timex-sinclair-projects/openspand-smd/card/docs/card-render-back.png

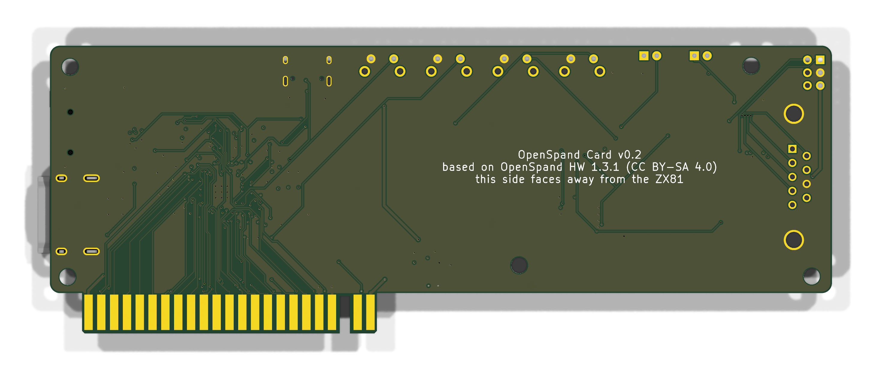
card/docs/card-render-back.png
