timex-sinclair-projects/openspand-smd/card/hardware/fab/BOM-JLCPCB.csv

Comment | Designator | Footprint | LCSC Part #
CR2032 | BT1 | BatteryHolder_Keystone_3034_1x20mm | C5213768
22u | C1 | C_0805_2012Metric | C45783
100n | C10,C11,C12,C13,C14,C15,C16,C17,C18,C19,C20,C24,C25,C26,C29,C30,C31,C33,C32,C34,C45 | C_0603_1608Metric | C14663
10u | C2,C3,C4,C35 | C_0805_2012Metric | C15850
4.7u | C22,C23,C21 | C_0603_1608Metric | C19666
15p | C27,C28 | C_0603_1608Metric | C1644
1u | C5,C46 | C_0603_1608Metric | C15849
B5819W | D1,D2,D5 | D_SOD-123 | C8598
USB-C | J3 | USB_C_Receptacle_HRO_TYPE-C-31-M-12 | C165948
microSD | J5 | TF-01A | C91145
HDMI | J8 | HDMI_A_Molex_208658-1001_Horizontal | C916313
33 | R1 | R_0603_1608Metric | C23140
1k | R2,R4 | R_0603_1608Metric | C21190
2.2k | R22,R23 | R_0603_1608Metric | C4190
220 | R24,R25,R26,R27,R28,R29,R30,R31 | R_0402_1005Metric | C25091
10k | R3,R11,R12,R13,R14,R15 | R_0603_1608Metric | C25804
5.1k | R5,R6 | R_0603_1608Metric | C23186
27 | R7,R8 | R_0603_1608Metric | C25190
4.7k | R9,R10 | R_0603_1608Metric | C23162
ME6211C33M5G | U1 | SOT-23-5 | C82942
TPD4E05U06DQAR | U10,U11 | USON-10_2.5x1.0mm_P0.5mm | C138714
RP2350B | U2 | QFN-80-1EP_10x10mm_P0.4mm_EP3.4x3.4mm | C42415655
W25Q128JVSIQ | U3 | SOIC-8_5.3x5.3mm_P1.27mm | C97521
MCP23009-E/SS | U4 | SSOP-20_5.3x7.2mm_P0.65mm | C629436
DS3231MZ+TRL | U5 | SOIC-8_3.9x4.9mm_P1.27mm | C107410
FT24C32A | U6 | SOIC-8_3.9x4.9mm_P1.27mm | C232883
SN74LVC3G34DCUR | U8 | VSSOP-8_2.3x2mm_P0.5mm | C130024
ME6211C12M5G-N | U9 | SOT-23-5 | C236672
12MHz | Y1 | Crystal_SMD_3225-4Pin_3.2x2.5mm | C20625731
