timex-sinclair-projects/openspand-smd/card/hardware/fab/hand-solder.csv

Designator | Value | Footprint | Note
SW1 | Reset | SW_Tactile_SPST_Angled_PTS645Vx83-2LFS | right-angle THT button on the top edge, hand-soldered
SW2 | RUN | SW_Tactile_SPST_Angled_PTS645Vx83-2LFS | right-angle THT button on the top edge, hand-soldered
SW3 | BOOTSEL | SW_Tactile_SPST_Angled_PTS645Vx83-2LFS | right-angle THT button on the top edge, hand-soldered
SW4 | Config | SW_Tactile_SPST_Angled_PTS645Vx83-2LFS | right-angle THT button on the top edge, hand-soldered
J4 | Joystick | DSUB-9_Male_Horizontal_P2.77x2.84mm_EdgePinOffset4.94mm_Housed_MountingHolesOffset7.48mm | Atari-style joystick, hand-soldered THT
J6 | External SPI | PinHeader_2x03_P2.54mm_Vertical
D3 | Red | LED_D3.0mm_Horizontal_O1.27mm_Z2.0mm | 3 mm red diffused, legs bent 90 deg, looks out of the top edge; driven by the I/O expander (GP2, open drain, active low); hand-soldered THT
D4 | Green | LED_D3.0mm_Horizontal_O1.27mm_Z2.0mm | 3 mm green diffused, legs bent 90 deg, looks out of the top edge; hand-soldered THT
