timex-sinclair-projects/openspand-smd/card/hardware/OpenSpand-Card.kicad_pcb

## KiCad design card/hardware/OpenSpand-Card.kicad_pcb (2026-11-07)

Schematic: OpenSpand-Card.kicad_sch, OpenSpand Card

Parts:
BT1: CR2032; BatteryHolder_Keystone_3034_1x20mm; MPN Keystone 3034TR; LCSC C5213768
C1: 22u; C_0805_2012Metric; LCSC C45783
C2, C3, C4, C35: 10u; C_0805_2012Metric; LCSC C15850
C5, C46: 1u; C_0603_1608Metric; LCSC C15849
C10, C11, C12, C13, C14, C15, C16, C17, C18, C19, C20, C24, C25, C26, C29, C30, C31, C32, C33, C34, C45: 100n; C_0603_1608Metric; LCSC C14663
C21, C22, C23: 4.7u; C_0603_1608Metric; LCSC C19666
C27, C28: 15p; C_0603_1608Metric; LCSC C1644
D1, D2, D5: B5819W; D_SOD-123; LCSC C8598
D3: Red; LED_D3.0mm_Horizontal_O1.27mm_Z2.0mm; MPN Kingbright WP710A10ID; not fitted
D4: Green; LED_D3.0mm_Horizontal_O1.27mm_Z2.0mm; MPN Kingbright WP710A10GD; not fitted
H1, H2, H3, H4, H5: M3; MountingHole_3.2mm_M3
J1: ZX81 edge; ZX81_EdgeFingers
J3: USB-C; USB_C_Receptacle_HRO_TYPE-C-31-M-12; LCSC C165948
J4: Joystick; DSUB-9_Male_Horizontal_P2.77x2.84mm_EdgePinOffset4.94mm_Hou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
J5: microSD; TF-01A; LCSC C91145
J6: External SPI; PinHeader_2x03_P2.54mm_Vertical; not fitted
J8: HDMI; HDMI_A_Molex_208658-1001_Horizontal; MPN Molex 2086581001; LCSC C916313
JP1: 5V pin 7; SolderJumper-2_P1.3mm_Open_RoundedPad1.0x1.5mm
JP2: 5V pin 5; SolderJumper-2_P1.3mm_Open_RoundedPad1.0x1.5mm
R1: 33; R_0603_1608Metric; LCSC C23140
R2, R4: 1k; R_0603_1608Metric; LCSC C21190
R3, R11, R12, R13, R14, R15: 10k; R_0603_1608Metric; LCSC C25804
R5, R6: 5.1k; R_0603_1608Metric; LCSC C23186
R7, R8: 27; R_0603_1608Metric; LCSC C25190
R9, R10: 4.7k; R_0603_1608Metric; LCSC C23162
R22, R23: 2.2k; R_0603_1608Metric; LCSC C4190
R24, R25, R26, R27, R28, R29, R30, R31: 220; R_0402_1005Metric; LCSC C25091
SW1: Reset; SW_Tactile_SPST_Angled_PTS645Vx83-2LFS; MPN C&K PTS645VL83-2 LFS; not fitted
SW2: RUN; SW_Tactile_SPST_Angled_PTS645Vx83-2LFS; MPN C&K PTS645VL83-2 LFS; not fitted
SW3: BOOTSEL; SW_Tactile_SPST_Angled_PTS645Vx83-2LFS; MPN C&K PTS645VL83-2 LFS; not fitted
SW4: Config; SW_Tactile_SPST_Angled_PTS645Vx83-2LFS; MPN C&K PTS645VL83-2 LFS; not fitted
U1: ME6211C33M5G; SOT-23-5; LCSC C82942
U2: RP2350B; QFN-80-1EP_10x10mm_P0.4mm_EP3.4x3.4mm; LCSC C42415655
U3: W25Q128JVSIQ; SOIC-8_5.3x5.3mm_P1.27mm; LCSC C97521
U4: MCP23009-E/SS; SSOP-20_5.3x7.2mm_P0.65mm; LCSC C629436
U5: DS3231MZ+TRL; SOIC-8_3.9x4.9mm_P1.27mm; LCSC C107410
U6: FT24C32A; SOIC-8_3.9x4.9mm_P1.27mm; LCSC C232883
U8: SN74LVC3G34DCUR; VSSOP-8_2.3x2mm_P0.5mm; LCSC C130024
U9: ME6211C12M5G-N; SOT-23-5; LCSC C236672
U10, U11: TPD4E05U06DQAR; USON-10_2.5x1.0mm_P0.5mm; LCSC C138714
Y1: 12MHz; Crystal_SMD_3225-4Pin_3.2x2.5mm; MPN ABM8-272-T3; LCSC C20625731

Connections:
/5VZX: D1.2 (A), J1.A5 (~ROMCS), J1.A27 (+5V), J1.C26 (~RAMCS)
/+1V2: C18.1, C19.1, C20.1, C21.1, U2.10 (DVDD), U2.32 (DVDD), U2.51 (DVDD), U9.5 (V_{OUT})
/+3V3: C3.1, C4.1, C10.1, C11.1, C12.1, C13.1, C14.1, C15.1, C16.1, C17.1, C22.1, C24.1, C25.1, C26.1, C30.1, C31.1, C32.1, C33.1, C34.1, C35.1, C45.1, C46.1, J5.4 (VDD), R1.1, R3.1, R9.1, R10.1, R11.1, R12.1, R13.1, R14.1, R15.1, R22.1, U1.5 (V_{OUT}), U2.5 (IOVDD), U2.15 (IOVDD), U2.24 (IOVDD), U2.29 (IOVDD), U2.41 (IOVDD), U2.50 (IOVDD), U2.59 (ADC_AVDD), U2.60 (IOVDD), U2.64 (VREG_VIN), U2.68 (USB_OTP_VDD), U2.69 (QSPI_IOVDD), U2.76 (IOVDD), U3.8 (VCC), U4.1 (VDD), U4.5 (ADDR), U4.6 (~RESET), U5.2 (VCC), U6.8 (VCC), U8.8 (VCC), U9.1 (V_{IN}), U9.3 (CE)
/+5V: C1.1, C2.1, D1.1 (K), D2.1 (K), D5.2 (A), J6.5, JP1.1 (A), JP2.1 (A), U1.1 (V_{IN}), U1.3 (CE)
/BOOT: R4.2, SW3.1
/CONFIG: SW4.1, U4.8 (GP0)
/GND: BT1.2 (-), C1.2, C2.2, C3.2, C4.2, C5.2, C10.2, C11.2, C12.2, C13.2, C14.2, C15.2, C16.2, C17.2, C18.2, C19.2, C20.2, C21.2, C22.2, C23.2, C24.2, C25.2, C26.2, C27.2, C28.2, C29.2, C30.2, C31.2, C32.2, C33.2, C34.2, C35.2, C45.2, C46.2, J1.A23 (0V), J1.A24 (0V), J3.A1 (GND), J3.A12 (GND), J3.B1 (GND), J3.B12 (GND), J3.SH (SHIELD), J4.0 (SHIELD), J4.8 (GND), J5.6 (VSS), J5.10 (SHIELD), J5.11 (SHIELD), J5.12 (SHIELD), J5.13 (SHIELD), J6.3, J8.2 (D2S), J8.5 (D1S), J8.8 (D0S), J8.11 (CKS), J8.17 (GND), J8.SH, R5.2, R6.2, R23.2, SW1.2, SW2.2, SW3.2, SW4.2, U1.2 (V_{SS}), U2.62 (VREG_PGND), U2.65 (VREG_FB), U2.81 (GND), U3.4 (GND), U4.20 (VSS), U5.5 (GND), U6.1 (A0), U6.2 (A1), U6.3 (A2), U6.4 (GND), U6.7 (WP), U8.3 (2A), U8.4 (GND), U8.6 (3A), U9.2 (V_{SS}), U10.3 (GND), U10.8 (GND), U11.3 (GND), U11.8 (GND), Y1.2 (G), Y1.4 (G)
/HDMI_5V: D5.1 (K), J8.18 (+5V)
/HSTX_CKN: R31.1, U2.11 (GPIO12)
/HSTX_CKP: R30.1, U2.12 (GPIO13)
/HSTX_D0N: R29.1, U2.13 (GPIO14)
/HSTX_D0P: R28.1, U2.14 (GPIO15)
/HSTX_D1N: R27.1, U2.16 (GPIO16)
/HSTX_D1P: R26.1, U2.17 (GPIO17)
/HSTX_D2N: R25.1, U2.18 (GPIO18)
/HSTX_D2P: R24.1, U2.19 (GPIO19)
/I2C_SCL: R10.2, U2.54 (GPIO43/ADC3), U4.3 (SCL), U5.8 (SCL), U6.6 (SCL)
/I2C_SDA: R9.2, U2.53 (GPIO42/ADC2), U4.4 (SDA), U5.7 (SDA), U6.5 (SDA)
/JOY_D: J4.2 (DOWN), U4.16 (GP6)
/JOY_F: J4.6 (FIRE), U4.13 (GP3)
/JOY_L: J4.3 (LEFT), U4.15 (GP5)
/JOY_P5: J4.5, JP2.2 (B)
/JOY_P7: J4.7, JP1.2 (B)
/JOY_R: J4.4 (RIGHT), U4.14 (GP4)
/JOY_U: J4.1 (UP), U4.17 (GP7)
/LED_GREEN: D4.2 (A), U2.52 (GPIO41/ADC1)
/LED_G_K: D4.1 (K), R23.1
/LED_RED: D3.1 (K), U4.12 (GP2)
/LED_R_A: D3.2 (A), R22.2
/QSPI_SCLK: U2.71 (QSPI_SCLK), U3.6 (CLK)
/QSPI_SD0: U2.72 (QSPI_SD0), U3.5 (DI/IO_{0})
/QSPI_SD1: U2.74 (QSPI_SD1), U3.2 (DO/IO_{1})
/QSPI_SD2: U2.73 (QSPI_SD2), U3.3 (~WP/IO_{2})
/QSPI_SD3: U2.70 (QSPI_SD3), U3.7 (~HOLD/~RESET/IO_{3})
/QSPI_SS: R4.1, U2.75 (~QSPI_SS), U3.1 (~CS)
/RUN: C29.1, R3.2, SW2.1, U2.35 (RUN)
/SD_CLK: J5.5 (CLK), J6.4, U2.57 (GPIO46/ADC6)
/SD_CS: J5.2 (DAT3/CS), R11.2, U2.56 (GPIO45/ADC5)
/SD_DAT1: J5.8 (DAT1), R14.2
/SD_DAT2: J5.1 (DAT2), R15.2
/SD_MISO: J5.7 (DAT0/DO), J6.2, R13.2, U2.55 (GPIO44/ADC4)
/SD_MOSI: J5.3 (CMD/DI), J6.6, R12.2, U2.58 (GPIO47/ADC7)
/SPI_CS: J6.1, U4.9 (GP1)
/TMDS_CKN: J8.12 (CK-), R31.2, U11.5 (IO4), U11.6 (IO4)
/TMDS_CKP: J8.10 (CK+), R30.2, U11.4 (IO3), U11.7 (IO3)
/TMDS_D0N: J8.9 (D0-), R29.2, U11.2 (IO2), U11.9 (IO2)
/TMDS_D0P: J8.7 (D0+), R28.2, U11.1 (IO1), U11.10 (IO1)
/TMDS_D1N: J8.6 (D1-), R27.2, U10.5 (IO4), U10.6 (IO4)
/TMDS_D1P: J8.4 (D1+), R26.2, U10.4 (IO3), U10.7 (IO3)
/TMDS_D2N: J8.3 (D2-), R25.2, U10.2 (IO2), U10.9 (IO2)
/TMDS_D2P: J8.1 (D2+), R24.2, U10.1 (IO1), U10.10 (IO1)
/USB_CC1: J3.A5 (CC1), R5.1
/USB_CC2: J3.B5 (CC2), R6.1
/USB_C_DM: J3.A7 (D-), J3.B7 (D-), R8.1
/USB_C_DP: J3.A6 (D+), J3.B6 (D+), R7.1
/USB_DM: R8.2, U2.66 (USB_DM)
/USB_DP: R7.2, U2.67 (USB_DP)
/VBAT: BT1.1 (+), U5.6 (VBAT)
/VBUS: D2.2 (A), J3.A4 (VBUS), J3.A9 (VBUS), J3.B4 (VBUS), J3.B9 (VBUS)
/VREG_AVDD: C23.1, R1.2, U2.61 (VREG_AVDD)
/XIN: C27.1, U2.30 (XIN), Y1.1
/XOUT: R2.1, U2.31 (XOUT)
/XOUT_X: C28.1, R2.2, Y1.3
/Z80_A0: J1.A21 (A0), U2.6 (GPIO8)
/Z80_A1: J1.A20 (A1), U2.7 (GPIO9)
/Z80_A2: J1.A19 (A2), U2.8 (GPIO10)
/Z80_A3: J1.A18 (A3), U2.9 (GPIO11)
/Z80_A4: J1.A6 (A4), U2.39 (GPIO31)
/Z80_A5: J1.A7 (A5), U2.38 (GPIO30)
/Z80_A6: J1.A8 (A6), U2.37 (GPIO29)
/Z80_A7: J1.A9 (A7), U2.36 (GPIO28)
/Z80_A8: J1.A10 (A8), U2.28 (GPIO27)
/Z80_A9: J1.A11 (A9), U2.27 (GPIO26)
/Z80_A10: J1.A12 (A10), U2.26 (GPIO25)
/Z80_A11: J1.A13 (A11), U2.25 (GPIO24)
/Z80_A12: J1.A14 (A12), U2.23 (GPIO23)
/Z80_A13: J1.A15 (A13), U2.22 (GPIO22)
/Z80_A14: J1.A16 (A14), U2.21 (GPIO21)
/Z80_A15: J1.A17 (A15), U2.20 (GPIO20)
/Z80_CLK: J1.A22 (CLK), U8.1 (1A)
/Z80_CLK_3V3: U2.49 (GPIO40/ADC0), U8.7 (1Y)
/Z80_D0: J1.C24 (D0), U2.77 (GPIO0)
/Z80_D1: J1.C23 (D1), U2.78 (GPIO1)
/Z80_D2: J1.C22 (D2), U2.79 (GPIO2)
/Z80_D3: J1.C19 (D3), U2.80 (GPIO3)
/Z80_D4: J1.C18 (D4), U2.1 (GPIO4)
/Z80_D5: J1.C20 (D5), U2.2 (GPIO5)
/Z80_D6: J1.C21 (D6), U2.3 (GPIO6)
/Z80_D7: J1.C27 (D7), U2.4 (GPIO7)
/Z80_HALT: J1.C15 (~HALT), U2.40 (GPIO32)
/Z80_IORQ: J1.C13 (~IORQ), U2.43 (GPIO34)
/Z80_M1: J1.C6 (~M1), U2.47 (GPIO38)
/Z80_MREQ: J1.C14 (~MREQ), U2.42 (GPIO33)
/Z80_RD: J1.C12 (~RD), U2.44 (GPIO35)
/Z80_RFSH: J1.C5 (~RFSH), U2.48 (GPIO39)
/Z80_RST: C5.1, J1.C7 (~RESET), SW1.1, U2.46 (GPIO37)
/Z80_WR: J1.C11 (~WR), U2.45 (GPIO36)

Notes on the sheet:
Power
ZX81 bus
MCU
USB
I2C
SD card
Video & I/O
Mechanical

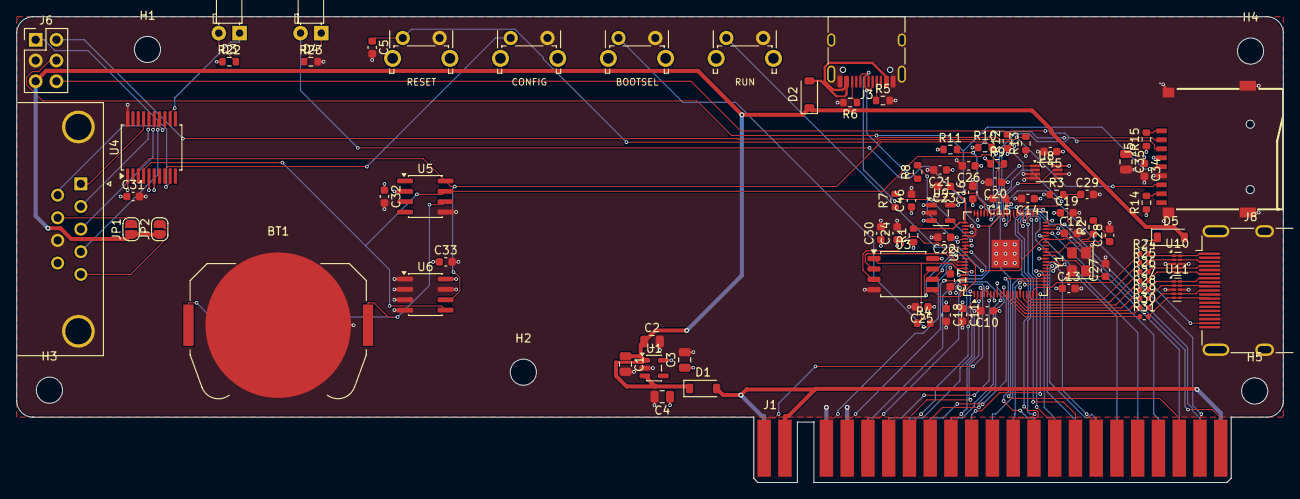
[picture p9: board OpenSpand-Card.kicad_pcb from above]

Board: 4 copper layers, 155.0 x 57.0 mm, 92 parts (0 on the bottom side), 97 nets.
