timex-sinclair-projects/openspand-smd/bus/hardware/ZX81-Bus.kicad_pcb

## KiCad design bus/hardware/ZX81-Bus.kicad_pcb (2026-11-07)

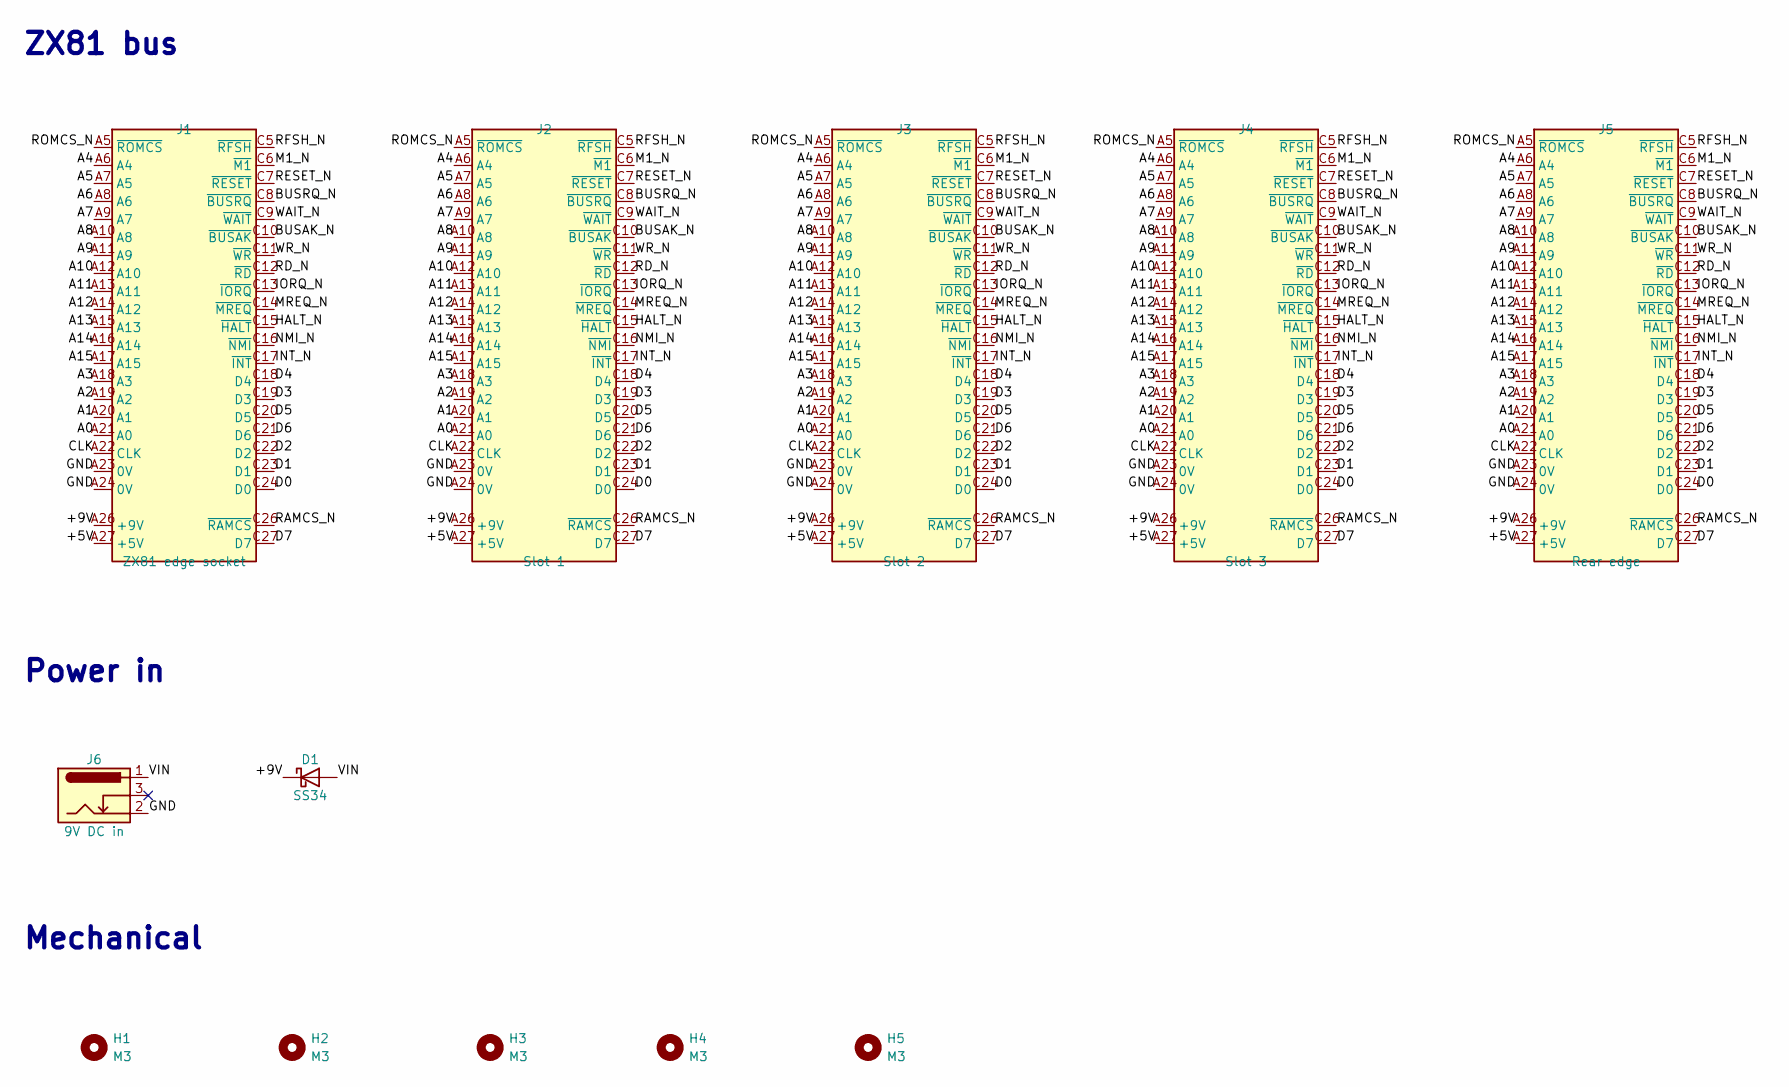
[picture p10: schematic ZX81-Bus.kicad_sch, ZX81 Bus, 3 slots]

Parts:
D1: SS34; D_SMA; LCSC C8678
H1, H2, H3, H4, H5: M3; MountingHole_3.2mm_M3
J1: ZX81 edge socket; ZX81_EdgeStraddle
J2: Slot 1; ZX81_Slot_2x23_P2.54mm_Row5.08mm
J3: Slot 2; ZX81_Slot_2x23_P2.54mm_Row5.08mm
J4: Slot 3; ZX81_Slot_2x23_P2.54mm_Row5.08mm
J5: Rear edge; ZX81_EdgeFingers_Rear
J6: 9V DC in; BarrelJack_CUI_PJ-102AH_Horizontal

Connections:
/+5V: J1.A27 (+5V), J2.A27 (+5V), J3.A27 (+5V), J4.A27 (+5V), J5.A27 (+5V)
/+9V: D1.1 (K), J1.A26 (+9V), J2.A26 (+9V), J3.A26 (+9V), J4.A26 (+9V), J5.A26 (+9V)
/A0: J1.A21 (A0), J2.A21 (A0), J3.A21 (A0), J4.A21 (A0), J5.A21 (A0)
/A1: J1.A20 (A1), J2.A20 (A1), J3.A20 (A1), J4.A20 (A1), J5.A20 (A1)
/A2: J1.A19 (A2), J2.A19 (A2), J3.A19 (A2), J4.A19 (A2), J5.A19 (A2)
/A3: J1.A18 (A3), J2.A18 (A3), J3.A18 (A3), J4.A18 (A3), J5.A18 (A3)
/A4: J1.A6 (A4), J2.A6 (A4), J3.A6 (A4), J4.A6 (A4), J5.A6 (A4)
/A5: J1.A7 (A5), J2.A7 (A5), J3.A7 (A5), J4.A7 (A5), J5.A7 (A5)
/A6: J1.A8 (A6), J2.A8 (A6), J3.A8 (A6), J4.A8 (A6), J5.A8 (A6)
/A7: J1.A9 (A7), J2.A9 (A7), J3.A9 (A7), J4.A9 (A7), J5.A9 (A7)
/A8: J1.A10 (A8), J2.A10 (A8), J3.A10 (A8), J4.A10 (A8), J5.A10 (A8)
/A9: J1.A11 (A9), J2.A11 (A9), J3.A11 (A9), J4.A11 (A9), J5.A11 (A9)
/A10: J1.A12 (A10), J2.A12 (A10), J3.A12 (A10), J4.A12 (A10), J5.A12 (A10)
/A11: J1.A13 (A11), J2.A13 (A11), J3.A13 (A11), J4.A13 (A11), J5.A13 (A11)
/A12: J1.A14 (A12), J2.A14 (A12), J3.A14 (A12), J4.A14 (A12), J5.A14 (A12)
/A13: J1.A15 (A13), J2.A15 (A13), J3.A15 (A13), J4.A15 (A13), J5.A15 (A13)
/A14: J1.A16 (A14), J2.A16 (A14), J3.A16 (A14), J4.A16 (A14), J5.A16 (A14)
/A15: J1.A17 (A15), J2.A17 (A15), J3.A17 (A15), J4.A17 (A15), J5.A17 (A15)
/BUSAK_N: J1.C10 (~BUSAK), J2.C10 (~BUSAK), J3.C10 (~BUSAK), J4.C10 (~BUSAK), J5.C10 (~BUSAK)
/BUSRQ_N: J1.C8 (~BUSRQ), J2.C8 (~BUSRQ), J3.C8 (~BUSRQ), J4.C8 (~BUSRQ), J5.C8 (~BUSRQ)
/CLK: J1.A22 (CLK), J2.A22 (CLK), J3.A22 (CLK), J4.A22 (CLK), J5.A22 (CLK)
/D0: J1.C24 (D0), J2.C24 (D0), J3.C24 (D0), J4.C24 (D0), J5.C24 (D0)
/D1: J1.C23 (D1), J2.C23 (D1), J3.C23 (D1), J4.C23 (D1), J5.C23 (D1)
/D2: J1.C22 (D2), J2.C22 (D2), J3.C22 (D2), J4.C22 (D2), J5.C22 (D2)
/D3: J1.C19 (D3), J2.C19 (D3), J3.C19 (D3), J4.C19 (D3), J5.C19 (D3)
/D4: J1.C18 (D4), J2.C18 (D4), J3.C18 (D4), J4.C18 (D4), J5.C18 (D4)
/D5: J1.C20 (D5), J2.C20 (D5), J3.C20 (D5), J4.C20 (D5), J5.C20 (D5)
/D6: J1.C21 (D6), J2.C21 (D6), J3.C21 (D6), J4.C21 (D6), J5.C21 (D6)
/D7: J1.C27 (D7), J2.C27 (D7), J3.C27 (D7), J4.C27 (D7), J5.C27 (D7)
/GND: J1.A23 (0V), J1.A24 (0V), J2.A23 (0V), J2.A24 (0V), J3.A23 (0V), J3.A24 (0V), J4.A23 (0V), J4.A24 (0V), J5.A23 (0V), J5.A24 (0V), J6.2
/HALT_N: J1.C15 (~HALT), J2.C15 (~HALT), J3.C15 (~HALT), J4.C15 (~HALT), J5.C15 (~HALT)
/INT_N: J1.C17 (~INT), J2.C17 (~INT), J3.C17 (~INT), J4.C17 (~INT), J5.C17 (~INT)
/IORQ_N: J1.C13 (~IORQ), J2.C13 (~IORQ), J3.C13 (~IORQ), J4.C13 (~IORQ), J5.C13 (~IORQ)
/M1_N: J1.C6 (~M1), J2.C6 (~M1), J3.C6 (~M1), J4.C6 (~M1), J5.C6 (~M1)
/MREQ_N: J1.C14 (~MREQ), J2.C14 (~MREQ), J3.C14 (~MREQ), J4.C14 (~MREQ), J5.C14 (~MREQ)
/NMI_N: J1.C16 (~NMI), J2.C16 (~NMI), J3.C16 (~NMI), J4.C16 (~NMI), J5.C16 (~NMI)
/RAMCS_N: J1.C26 (~RAMCS), J2.C26 (~RAMCS), J3.C26 (~RAMCS), J4.C26 (~RAMCS), J5.C26 (~RAMCS)
/RD_N: J1.C12 (~RD), J2.C12 (~RD), J3.C12 (~RD), J4.C12 (~RD), J5.C12 (~RD)
/RESET_N: J1.C7 (~RESET), J2.C7 (~RESET), J3.C7 (~RESET), J4.C7 (~RESET), J5.C7 (~RESET)
/RFSH_N: J1.C5 (~RFSH), J2.C5 (~RFSH), J3.C5 (~RFSH), J4.C5 (~RFSH), J5.C5 (~RFSH)
/ROMCS_N: J1.A5 (~ROMCS), J2.A5 (~ROMCS), J3.A5 (~ROMCS), J4.A5 (~ROMCS), J5.A5 (~ROMCS)
/VIN: D1.2 (A), J6.1
/WAIT_N: J1.C9 (~WAIT), J2.C9 (~WAIT), J3.C9 (~WAIT), J4.C9 (~WAIT), J5.C9 (~WAIT)
/WR_N: J1.C11 (~WR), J2.C11 (~WR), J3.C11 (~WR), J4.C11 (~WR), J5.C11 (~WR)

Notes on the sheet:
ZX81 bus
Power in
Mechanical

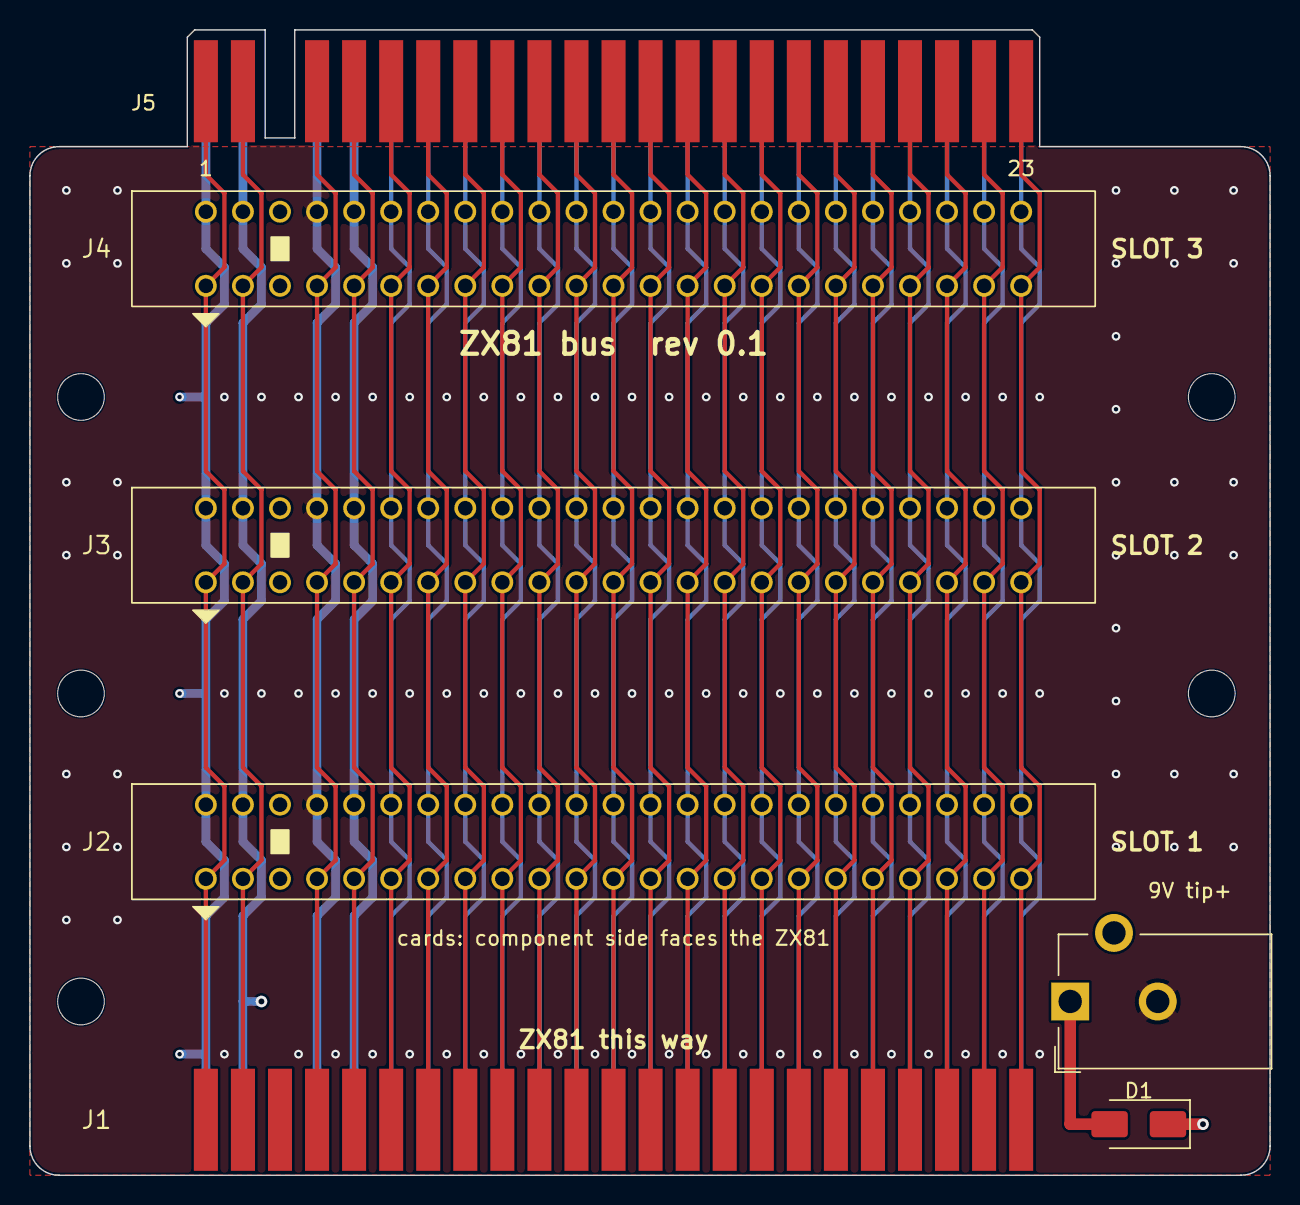
[picture p11: board ZX81-Bus.kicad_pcb from above]

Board: 4 copper layers, 85.0 x 78.5 mm, 12 parts (0 on the bottom side), 44 nets.
