timex-sinclair-projects/openspand-smd/(commit log)

2026-11-02 Add OpenSpand SMD and SMD2 board designs
    OpenSpand SMD: chip-down, surface-mount OpenSpand (RP2350B, PCM5102A,
    DS1307, MCP23009) on a 4-layer 100 x 70 mm board for JLCPCB assembly.
    Keeps the upstream GPIO map, so the stock firmware runs unchanged.
    Fully routed; DRC and ERC clean.
    OpenSpand SMD2 (smd2/): the same circuit laid out for easier routing.
    The GPIO map follows the ZX81 edge socket's pin order, U2 is turned
    to face the socket, and the I2C expansion header is dropped. Routes
    with 24% fewer signal vias and no hand fixes. Needs the pin-map patch
    in smd2/firmware/ (not yet compiled or tested).
    [BOM-JLCPCB.csv, OpenSpand-SMD.kicad_pcb, OpenSpand-SMD.kicad_sch, OpenSpand-SMD2.kicad_pcb, OpenSpand-SMD2.kicad_sch, hand-solder.csv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]
2026-11-02 Add OpenSpand Card: SMD2 on a ZX81 edge-connector card
    A 155 x 57 mm card with ZX81 gold fingers that stands upright in a
    socket on an expansion bus. It is the SMD2 circuit with:
    - DE-9 and composite RCA jack on the right edge, microSD and line out
    on the left edge, USB-C, buttons and headers along the top, and the
    CR2032 on the bottom edge with its holder opening outward
    - the data and control GPIO groups swapped to suit the fingers being
    on the component side (firmware/card-pins.patch)
    - silkscreen names on the RESET, CONFIG, BOOTSEL and RUN buttons
    - placement that turns two-pin passives so the non-ground pad faces
    the pin it serves
    Fully routed; DRC is clean apart from silkscre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
    [BOM-JLCPCB.csv, OpenSpand-Card.kicad_pcb, OpenSpand-Card.kicad_sch, hand-solder.csv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]
2026-11-02 Make the OpenSpand Card the main design in the README
    The top-level README now introduces the card, with its renders, the
    module-to-chip table, the card's GPIO map, JLCPCB ordering with gold
    fingers, and the pre-order checklist. The original SMD write-up moves
    to SMD.md, and SMD2's links follow it.
2026-11-02 Retire the original OpenSpand SMD board
    SMD kept upstream's GPIO map, which puts A8-A15 on the RP2350B's ADC
    pins, which aren't 5 V tolerant. SMD2 and the card fix that, so remove
    SMD's tools/, hardware/ and SMD.md; it stays in the history.
    The routing-pipeline description moves into card/README.md. SMD2's
    README now points at the card for the pipeline and ordering steps and
    carries its own DE-9 and edge-socket notes.
    [BOM-JLCPCB.csv, OpenSpand-SMD.kicad_pcb, OpenSpand-SMD.kicad_sch, hand-solder.csv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]
2026-11-02 Drop the RTC; follow the RP2350 design guide for Y1, L1 and VREG_AVDD
    - Remove the DS1307 real-time clock (U5, Y2, BT1, C32). The firmware's
    GET TIM / GET DAT and time/date menu screens read 0xFF without it;
    nothing else uses the clock.
    - Y1: Abracon ABM8-272-T3 (C20625731), the crystal Raspberry Pi
    specifies for the 15 pF load caps and 1k series resistor.
    - C23: 4.7 uF on VREG_AVDD (was 100 nF), completing the 33 ohm / 4.7 uF
    filter.
    - L1: new footprint with a silkscreen polarity dot at pad 1, now the
    +1V1 end, per RP2350 datasheet figures 25 and 28 (the old README had
    the dot at VREG_LX, which was backwards).
    - No pour on F.Cu or In1 under L1 and the VREG_LX node (figure 27).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
    [BOM-JLCPCB.csv, OpenSpand-Card.kicad_pcb, OpenSpand-Card.kicad_sch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]
2026-11-03 Add a crystal-free DS3231MZ RTC and three case screw holes
    - U5: DS3231MZ+TRL (C107410) at 0x68 on the I2C bus, with C32 decoupling.
    Its built-in MEMS resonator needs no 32.768 kHz crystal, and it shares
    the DS1307's address and time registers, so the firmware is unchanged.
    - BT1: CR2032 holder (Keystone 3034) back at the bottom edge. Backup only;
    nothing charges it.
    - H3, H4, H5: M3 holes for enclosure screw posts at lower left, top right
    and bottom right (inboard of the RCA jack, clear of the finger fan-out).
    - Re-routed: DRC clean apart from silkscreen, ERC clean, parity clean.
    Fab files, renders and READMEs updated.
    [BOM-JLCPCB.csv, OpenSpand-Card.kicad_pcb, OpenSpand-Card.kicad_sch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]
2026-11-04 Replace composite video with VGA; rearrange the card's edges
    - VGA: HD-15 socket J8 (BOOMELE VGA-002, LCSC C138387) on the right edge.
    GPIO36/37 drive HSYNC/VSYNC through 33R; GPIO40 carries mono video into
    an SN74LVC3G34 triple buffer (U8, C130024) that drives R, G and B through
    270R each (about 0.7 V into 75R).
    - The RCA jack, its resistors and the 75R termination jumper are removed.
    GPIO40 was the ZX81 serial port's TX, so the UART and header J10 go;
    GPIO41 is spare. Both LEDs and stereo sampled audio stay.
    - Joystick DE-9 and its MCP23009 move to the left edge, above the line
    out; microSD moves to the top edge beside USB-C, above U2's SD pins.
    - Holes: H1 moves inboard of the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
    [BOM-JLCPCB.csv, OpenSpand-Card.kicad_pcb, OpenSpand-Card.kicad_sch, hand-solder.csv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]
2026-11-04 Right-angle buttons through the top edge; move the VGA socket down 3 mm
    SW1-SW4 become XKB TS-1102US-C-I (C2885134) side-push switches whose
    3.5 mm plungers stick out about 3.7 mm past the top edge, so they can be
    pressed through the top of a case. The footprint is generated from XKB's
    drawing; EasyEDA's 3D model gets the long plunger added. The SWD header
    moves inboard to make room, and the VGA socket drops 3 mm.
    Re-routed: 308 vias (158 signal), 3682 mm of track, DRC silkscreen only,
    parity 0, ERC 0.
    [BOM-JLCPCB.csv, OpenSpand-Card.kicad_pcb, OpenSpand-Card.kicad_sch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]
2026-11-04 Feed the RP2350 core from an LDO; hand-fitted THT buttons
    Replace L1 and the RP2350's on-chip switcher with an ME6211C12 LDO (U9,
    C236672) on DVDD, per RP2350 datasheet section 6.3.7: VREG_LX open,
    VREG_FB to GND, VREG_VIN and VREG_AVDD still powered. 1.2 V matches the
    1.20 V the firmware sets for its 208 MHz overclock. The core net is now
    +1V2.
    SW1-SW4 become C&K PTS645VL83-2 LFS right-angle through-hole switches,
    marked DNP for hand soldering, with plungers about 5.8 mm past the top
    edge. The unused XKB footprint and models are removed.
    Re-routed: 299 vias (148 signal), 3655 mm of track, DRC silkscreen only,
    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
    [BOM-JLCPCB.csv, OpenSpand-Card.kicad_pcb, OpenSpand-Card.kicad_sch, hand-solder.csv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]
2026-11-04 Bring the UART back; drop the SWD and digitized-audio headers
    J2 (SWD) and J9 (digitized audio) are removed. VGA video moves from
    GPIO40 to GPIO38, so the VGA pins are consecutive (36-38), and the red
    LED moves to the I/O expander's GP2 (active low). That frees GPIO40/41
    for UART1 again, on header J10 (TX, RX, 5V, GND), the same pins as
    SMD2, so the patch's serial port code is unchanged.
    Firmware still to do: red LED via expander bit 2, and the VGA driver.
    Re-routed: 301 vias (150 signal), 3545 mm of track, DRC silkscreen
    only, parity 0, ERC 0.
    [OpenSpand-Card.kicad_pcb, OpenSpand-Card.kicad_sch, hand-solder.csv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]
2026-11-07 Rev 0.2: DVI on an HDMI socket in place of VGA; sound over HDMI
    HSTX, the RP2350's only route to DVI, is fixed to GPIO12..19, where rev 0.1
    had A4..A11. The bus now goes round it: D0..D7 and A0..A3 stay on GPIO0..11,
    A15..A4 move to GPIO20..31 (reversed, so they fan out without crossing;
    the firmware undoes it with one RBIT) and the control lines to GPIO32..39.
    That uses every 5 V-tolerant GPIO, so Z80_CLK reaches GPIO40 through the
    74LVC3G34 the VGA output no longer needs.
    HSTX's eight pins come out of I2S and the UART: the PCM5102A, line-out
    jack and UART header go, and sound is to go out as HDMI audio. The I/O
    expander, DS3231MZ and settings EEPROM stay on I2C unchanged (issue #7).
    The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
    [BOM-JLCPCB.csv, OpenSpand-Card.kicad_pcb, OpenSpand-Card.kicad_sch, hand-solder.csv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]
2026-11-07 Add the ZX81 bus board: three slots, rear pass-through edge, 9 V jack
    A passive 4-layer backplane (bus/). A 2x23 card-edge socket straddles
    the front edge (tails bent to pinch the board, soldered to 7 mm pads on
    both sides), so the board plugs onto the ZX81 in the same plane as its
    motherboard. Three vertical 2x23 slots at 0.8 in hold cards such as the
    OpenSpand Card, and the rear edge repeats the ZX81's edge as gold
    fingers for a RAM pack or another bus.
    Every connector has position n at the same x, so each signal is one
    straight run: C row on F.Cu, A row on B.Cu, stepping half a pitch round
    the other row's holes at each slot. In1 is GND, In2 +5V. gen_pcb.py
    draws every track; no autoroute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
    [ZX81-Bus.kicad_pcb, ZX81-Bus.kicad_sch, hand-solder.csv]
2026-11-07 microSD to the right edge; status LEDs to the top edge
    The microSD socket turns to face out of the right edge, above the HDMI
    socket, in the room the VGA socket left. D3 and D4 become LiteOn
    LTST-S270 side-looking LEDs on the top edge, left of RESET, so a case can
    show them. Rerouted: DRC silkscreen only, 0 unconnected, ERC clean; the
    TMDS pre-routes are unchanged.
    [BOM-JLCPCB.csv, OpenSpand-Card.kicad_pcb, OpenSpand-Card.kicad_sch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]
2026-11-07 Through-hole status LEDs with room round them; SPI header to the left edge
    D3 and D4 become 3 mm diffused THT LEDs (Kingbright WP710A10ID red,
    WP710A10GD green), hand-fitted with the legs bent so they look up out of
    the top edge, 10 mm apart where the SPI header was. R22 and R23 go to
    2.2k, about 0.6 mA red and 0.5 mA green, so they glow rather than glare.
    J6 moves to the top of the left edge and the DE-9 drops 10 mm to make
    room. The unused LTST-S270 footprint is gone. Rerouted: DRC silkscreen
    only, 0 unconnected, ERC clean; the TMDS pre-routes are unchanged.
    [BOM-JLCPCB.csv, OpenSpand-Card.kicad_pcb, OpenSpand-Card.kicad_sch, hand-solder.csv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]
