timex-sinclair-projects/openspand-smd/(notices)

Notices in the files:
card/firmware/pins.h:
OpenSpand is free software: you can redistribute it and/or modify it under the
terms of the GNU General Public License as published by the Free Software
bus/hardware/ZX81-Bus.kicad_sch:
Edge socket footprint from OpenSpand HW 1.3.1 by Adam Klotblixt & ZX-Team, CC BY-SA 4.0
